zhutianwei/HighLevel/README.md

# HighLevel
Process available data to produce a vehicle speed and direction
