zhutianwei/HighLevel/HighLevel_Test/README.txt

Area for testing High level to not affect the main system.
Added Serial.Print() statements and hard coded areas for 
testing and isolating parts of the code in the lab
while not having to deal with the problems of not getting
new GPS readings or no SD card with your specific board etc.

Synced with Main 6-13-19
