zhutianwei/HighLevel/Function-Test Sketches (All test sketches here)/SerialCmd.html

Serial commands

There are two formats for the keyword. Those starting with '$' are comma separated values, followed by a checksum. Commands starting with a character other than '$' have arguments grouped by braces into keywords and values. The former may be used with instruments; the latter is the format used for interprocessor communication.

DRIVE

GameBots serial command format allows replacement by the USARSim simulator. Since USARsim is no longer available, the Gamebots format has been modified:

1. D {s ComandedSpeed} {a ComandedSteerAngle}

Where:

{s ComandedSpeed} ComandedSpeed is an intege giving the speed for the rear wheel in centimeters per second.

The value is the speed, in centimeters / second.

{a ComandedSteerAngle} ComandedSteerAngle is an integer that specifies the steer angle

of Elcano’s front wheels. The value is the absolute steer angle, in degrees.

Example: D {s 259} {a -3}

SENSOR

A similar format will be used for sensed information from C6.

2. S {s ActualSpeed}

ActualSpeed gives the speed for the rear wheel.

The value is the speed, in centimeters per second.

Other sensors are:

3. S {a Deg}

Steering angle of the front wheels, in degrees times.

0 degrees is straight ahead, small positive numbers are degrees to the right.

Negative numbers (mod 360) are degrees to the left.

4. S {p EPosMeters,NPosMeters} {b Deg}

// Best estimate of vehicle position, fused from all sensors.

The East and North positions are relative to the origin.

Bearing tells which way the vehicle is pointing.

OTHER

5. G {n Num} {p EPosMeters,NPosMeters} {b Deg}

5a. G {n Num} {p EPosMeters,NPosMeters} {b Deg} {r Probability}

6. X {n Num} {p EPosMeters,NPosMeters} {b Deg} {s SegSpeed}

Goal gives the positions of the cones, which may be updated from visual information. The next goal is always {Num 1} If a bearing is present, it is the desired direction of approach to the goal.

The localization processor passes messages 4, SENSOR and 5, GOAL to the vision processor. The vision processor then computes the expected position of the cone in the image. After processing the image, it will compute an updated cone position, including the probability that a cone is present in the image. It passes message 5a back to the vision processor.

Segment 1 is the next desired position from the present position. These are followed by Segments 2, 3, 4, 5. Farther segments would not be transmitted. The speed on a segment is the recommended speed, taking account of conditions and turning radius.

GPS

NMEA Output sentences $GPxxx. These include $GPRMC, $GPVTG. $GPGGA, $GPGSA and $GPGSV. See http://www.adafruit.com/datasheets/GlobalTop-FGPMMOPA6H-Datasheet-V0A.pdf

Communication to the GPS receiver uses NMEA PMTK packets such as $PMTK220, $PMTK314 and $PMTK605. See http://www.adafruit.com/datasheets/PMTK_A08.pdf

Maps

Format is similar to NMEA output. '*xx' means the character '*' followed by a checksum.

$MAPLS,N*xx

Requests processor N to list the names of all maps.

$MAPTX,N,count,num,name*xx

Processor N transmits the name of map num of count. Count is the number of maps on the processor.

$MAPSL,N,name*xx

Request processor N to send contents of map 'name'.

$MAPLN,N,count,num,data*xx

Processor N sends line num of count for the requested map. 'Data' consists of

node,latitude,longitude,PositionEast,PositionNorth,Link1,Link2,Link3,Link4,Dist1,Dist2,Dist3,Dist4

Where

node is the name or number of the point.

latitude and longitude are in decimal degrees.

Positions are in meters

Links are other nodes that are directly linked to this node. If there are more than four, use two different names for the present node, but separate them by zero distance. If there are fewer than four, that field is blank.

Dist are distances in meters along the road to a node.

Example data:

8,47.760342,-122.189784,71.903,154.917,2,7,15,,268.441,142.961,269.358,

15,47.757929,-122.189467,95.599,-113.397,8,16,18,,269.358,26.369,182.216,

13,47.621921,-122.348628,170.313,69.008,14,,,,18.578,,,,

The maps themselves are internal to C4 and its SD card. They do not have to be transmitted. C4 needs to have additional information about the route. From this information, it will produce the next portion of the drive path, which will be transmitted to C3.

The map for the SD card must contain information about the links between nodes. Each link will have the following information:

$LNKLST,startNode,endNode,numberOfSegments,segmentIndex1,...,segmentIndexN

$LNKSEG,index,nextIndex,PositionEast,PositionNorth,bearing,width,speed
