zhutianwei/HighLevel/Function-Test Sketches (All test sketches here)/SelfDrive-master (previous high level code)/ReadMe.txt

The selfDrive-master is high level code wrote by previous capstone team. The algo still working but they use Elcano serial instead of CAN bus.
