zhutianwei/HighLevel/Function-Test Sketches (All test sketches here)/SelfDrive-master (previous high level code)/High_Level_System/README

This is the most updated High level System test with C6, C4 and C3 together. 
Make sure to also include the High-level-libraries when running this code.

Note: C4 is commented out because the A star algorithm still need further integration and testing.
