zhutianwei/HighLevel/Function-Test Sketches (All test sketches here)/SelfDrive-master (previous high level code)/High_Level_Test/README

This is the most updated version of the High level code with a mostly tested and working version of C6 and C3. 
Make sure to also include the High-level-libraries when running this code.
