zhutianwei/HighLevel/Electronics/High-Level PCB v3.0.brd

## EAGLE design Electronics/High-Level PCB v3.0.brd (2019-08-13)

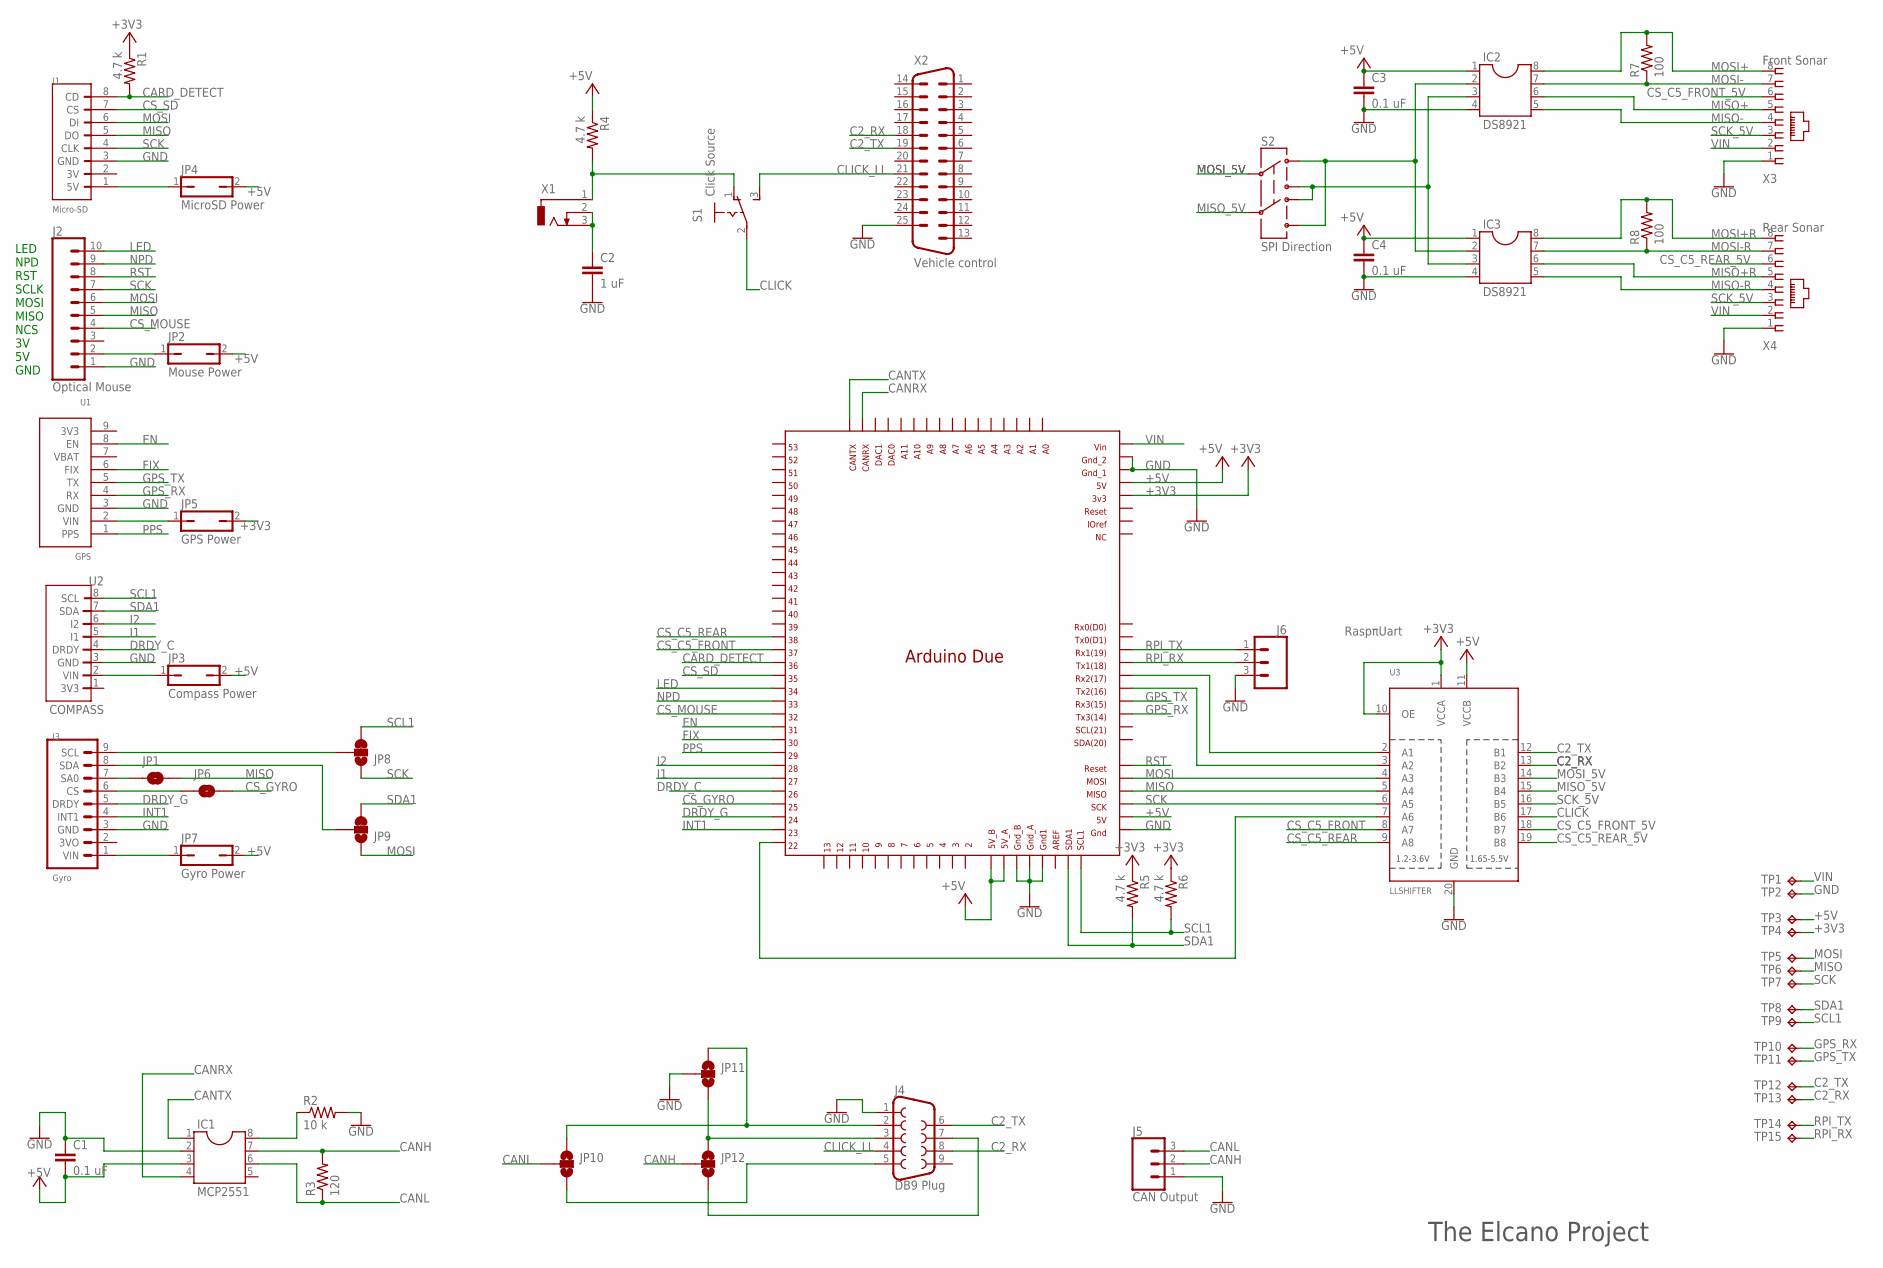
[picture p18: schematic High-Level PCB v3.0.sch]

Parts:
C1, C3, C4: 0.1 uF; C2.5-5
C2: 1 uF; C2.5-5
IC1: MCP2551; DIL08
IC2, IC3: DS8921; DIL08
J1: Micro-SD; ELSDCARD
J2: Optical Mouse; 1X10
J3: Gyro; ELGYRO
J4: DB9 Plug; DB9_MALE
J5: CAN Output; SCREWTERMINAL-5MM-3
J6: RaspπUart; 1X03
JP1, JP6: JUMPER-SMT_2_NO_SILK; SMT-JUMPER_2_NO_SILK
JP2: Mouse Power; JP1
JP3: Compass Power; JP1
JP4: MicroSD Power; JP1
JP5: GPS Power; JP1
JP7: Gyro Power; JP1
JP8, JP9: JUMPER-SMT_3_1-NC_TRACE_SILK; SMT-JUMPER_3_1-NC_TRACE_SILK
JP10, JP11, JP12: JUMPER-SMT_3_NO_SILK; SMT-JUMPER_3_NO_SILK
MCU1: DUE(NORMAL)
R1, R4, R5, R6: 4.7 k; 0204/7
R2: 10 k; 0204/7
R3: 120; 0204/7
R7, R8: 100; 0204/7
S1: Click Source; SP_ELSWITCH
S2: SPI Direction; DPDT
TP1, TP2, TP3, TP4, TP5, TP6, TP7, TP8, TP9, TP10, TP11, TP12, TP13, TP14, TP15: TPPAD1-17; P1-17
U1: GPS; ELGPS
U2: COMPASS; ELCOMPASS
U3: LLSHIFTER; ELSHIFTER
X1: 2.5MMJACK
X2: Vehicle control; M25H
X3: Front Sonar; RJ45-NO-SHIELD
X4: Rear Sonar; RJ45-NO-SHIELD

Connections:
+3V3: JP5.2, MCU1.3V3, R1.1, R5.1, R6.1, TP4.TP, U3.1 (VCCA), U3.10 (OE)
+5V: C1.2, C3.1, C4.1, IC1.3, IC2.1, IC3.1, JP2.2, JP3.2, JP4.2, JP7.2, MCU1.5V, MCU1.5V_A, MCU1.5V_B, MCU1.GND_ICSP, R4.1, TP3.TP, U3.11 (VCCB)
C2_RX: J4.8, TP13.TP, U3.13 (B2), X2.18
C2_TX: J4.6, TP12.TP, U3.12 (B1), X2.19
CANH: IC1.7, J5.2, JP12.2, R3.2
CANL: IC1.6, J5.3, JP10.2, R3.1
CANRX: IC1.4, MCU1.CANRX
CANTX: IC1.1, MCU1.CANTX
CARD_DETECT: J1.8 (CD), MCU1.36, R1.2
CLICK: S1.2, U3.17 (B6)
CLICK_LL: J4.4, S1.3 (S), X2.21
CS_C5_FRONT: MCU1.37, U3.8 (A7)
CS_C5_FRONT_5V: U3.18 (B7), X3.6
CS_C5_REAR: MCU1.38, U3.9 (A8)
CS_C5_REAR_5V: U3.19 (B8), X4.6
CS_GYRO: JP6.2, MCU1.25
CS_MOUSE: J2.4, MCU1.32
CS_SD: J1.7 (CS), MCU1.35
DRDY_C: MCU1.26, U2.4 (DRDY)
DRDY_G: J3.5 (DRDY), MCU1.24
EN: MCU1.31, U1.8 (EN)
FIX: MCU1.30, U1.6 (FIX)
GND: C1.1, C2.2, C3.2, C4.2, IC1.2, IC2.4, IC3.4, J1.3 (GND), J2.1, J3.3 (GND), J4.1, J5.1, J6.3, JP11.2, MCU1.5V_ICSP, MCU1.GND1, MCU1.GND_1, MCU1.GND_2, MCU1.GND_A, MCU1.GND_B, R2.2, TP2.TP, U1.3 (GND), U2.3 (GND), U3.20 (GND), X2.25, X3.1, X4.1
GPS_RX: MCU1.TX3, TP10.TP, U1.4 (RX)
GPS_TX: MCU1.RX3, TP11.TP, U1.5 (TX)
I1: MCU1.27, U2.5 (I1)
I2: MCU1.28, U2.6 (I2)
INT1: J3.4 (INT1), MCU1.23
LED: J2.10, MCU1.34
MISO: J1.5 (DO), J2.5, JP1.2, MCU1.MISO_ICSP, TP6.TP, U3.5 (A4)
MISO+: IC2.6, X3.5
MISO+R: IC3.6, X4.5
MISO-: IC2.5, X3.4
MISO-R: IC3.5, X4.4
MISO_5V: S2.5, U3.15 (B4)
MOSI: J1.6 (DI), J2.6, JP9.1, MCU1.MOSI_ICSP, TP5.TP, U3.4 (A3)
MOSI+: IC2.8, R7.2, X3.8
MOSI+R: IC3.8, R8.2, X4.8
MOSI-: IC2.7, R7.1, X3.7
MOSI-R: IC3.7, R8.1, X4.7
MOSI_5V: S2.2, U3.14 (B3)
unnamed: C2.1, X1.2, X1.3
unnamed: IC2.2, IC3.2, S2.1, S2.6
unnamed: IC2.3, IC3.3, S2.3, S2.4
unnamed: MCU1.TX2, U3.3 (A2)
unnamed: MCU1.RX2, U3.2 (A1)
unnamed: R4.2, S1.1 (O), X1.1
unnamed: JP3.1, U2.2 (VIN)
unnamed: J3.1 (VIN), JP7.1
unnamed: J1.1 (5V), JP4.1
unnamed: J4.3, JP11.3, JP12.1
unnamed: MCU1.22, U3.7 (A6)
unnamed: J2.2, JP2.1
unnamed: JP5.1, U1.2 (VIN)
unnamed: J4.5, JP10.3
unnamed: J4.7, JP12.3
unnamed: IC1.8, R2.1
unnamed: J4.2, JP10.1, JP11.1
unnamed: J3.6 (CS), JP6.1
unnamed: J3.7 (SA0), JP1.1
unnamed: J3.8 (SDA), JP9.2
unnamed: J3.9 (SCL), JP8.2
NPD: J2.9, MCU1.33
PPS: MCU1.29, U1.1 (PPS)
RPI_RX: J6.2 (1), MCU1.TX1, TP15.TP
RPI_TX: J6.1 (2), MCU1.RX1, TP14.TP
RST: J2.8, MCU1.RESET_ICSP
SCK: J1.4 (CLK), J2.7, JP8.1, MCU1.SCK_ICSP, TP7.TP, U3.6 (A5)
SCK_5V: U3.16 (B5), X3.3, X4.3
SCL1: JP8.3, MCU1.SCL1, R6.2, TP9.TP, U2.8 (SCL)
SDA1: JP9.3, MCU1.SDA1, R5.2, TP8.TP, U2.7 (SDA)
VIN: MCU1.VIN, TP1.TP, X3.2, X4.2

Notes on the sheet:
LED NPD RST SCLK MOSI MISO NCS 3V 5V GND
The Elcano Project

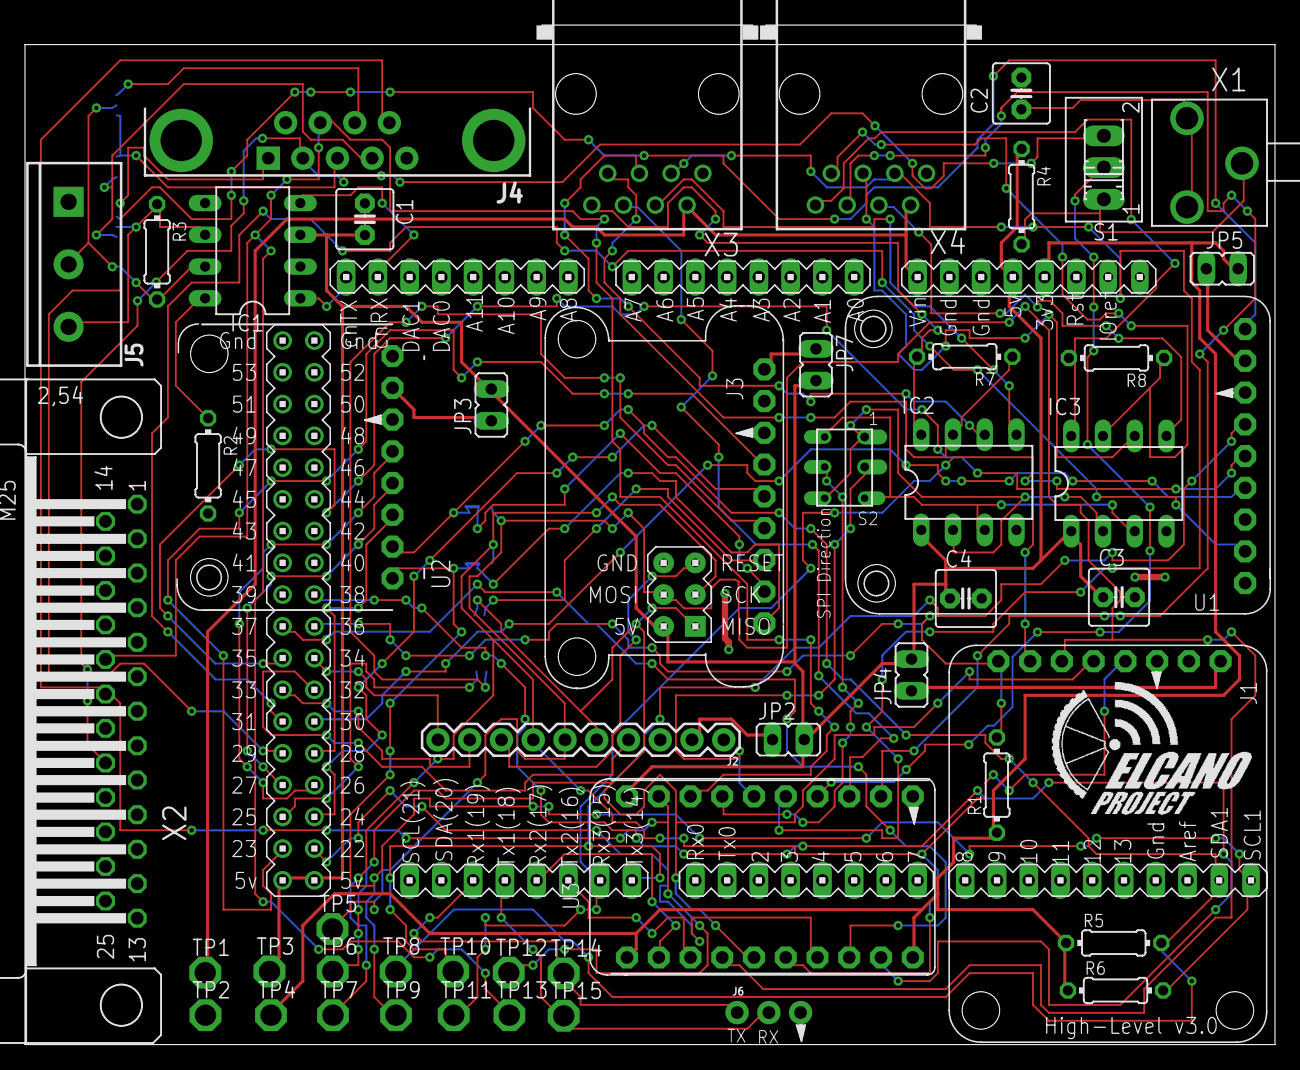
[picture p19: board High-Level PCB v3.0.brd from above]

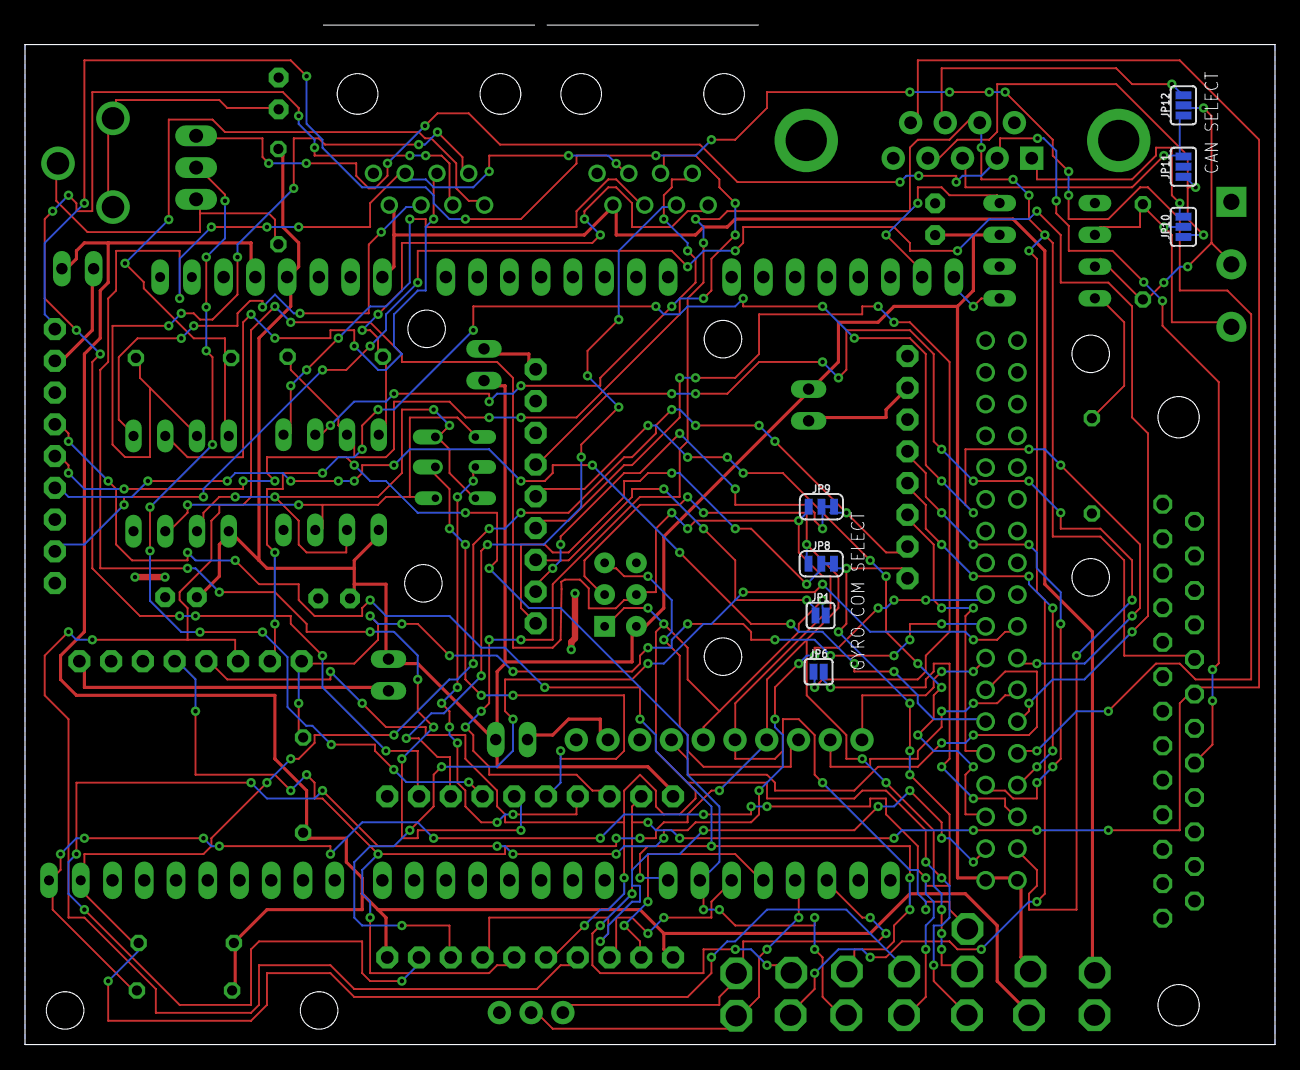
[picture p20: board High-Level PCB v3.0.brd from below]

Board: 2 copper layers, 100.0 x 81.6 mm, 58 parts (7 on the bottom side), 72 nets.
