zhutianwei/HighLevel/High_Level/Localization.cpp

#include "Localization.h"
#define mySerial Serial3

Adafruit_GPS GPS(&mySerial);
//Adafruit_L3GD20 gyro; GYRO still not working
//#ifdef USE_I2C

  // The default constructor uses I2C
  Adafruit_L3GD20 gyro;
//#else
 // To use SPI, you have to define the pins
 // #define GYRO_CS 4 // labeled CS
 // #define GYRO_DO 5 // labeled SA0
 // #define GYRO_DI 6  // labeled SDA
 // #define GYRO_CLK 7 // labeled SCL
 // Adafruit_L3GD20 gyro(GYRO_CS, GYRO_DO, GYRO_DI, GYRO_CLK);
//#endif

namespace elcano {
/******************************************************************************************************
 * constructor for Localization
 *  activates the GPS, Compass, Gyroscope and finds initial positoin
 *****************************************************************************************************/
Localization::Localization(Origin &org, Waypoint &estimated_position, Waypoint &oldPos) {
  //originSt = new elcano::Origin(47.760850, -122.190044); //center of UW soccer field
  //setting up the GPS rate
  setup_GPS();

  //Enable auto-gain
  mag.enableAutoRange(true);
  accel.enableAutoRange(true);
  
  if(!accel.begin())
  {
    /* There was a problem detecting the ADXL345 ... check your connections */
    if(DEBUG) Serial.println("Ooops, no accelerometer detected ... Check your wiring!");
  }
  if (!mag.begin()) {
    if(DEBUG)  Serial.println("no magnetometer detected ... Check your wiring!");
  }
  mag.begin();
  accel.begin();
  
  initial_position(org, estimated_position,oldPos); //getting your initial position from GPS comment out if no GPS available
  //set starting speed to 0 
  newPos.speed_mmPs = 0;
  
  // Try to initialise and warn if we couldn't detect the chip
  if (!gyro.begin(gyro.L3DS20_RANGE_250DPS))
  //if (!gyro.begin(gyro.L3DS20_RANGE_500DPS))
  //if (!gyro.begin(gyro.L3DS20_RANGE_2000DPS))
  {
    if(DEBUG) Serial.println("Oops ... unable to initialize the gyro. Check your wiring!");
  }
}

/********************************************************************************************************
 * setup_GPS()
 * initializes the GPSRATE chooses option of GGA
 *******************************************************************************************************/
void Localization::setup_GPS() {
  //Serial 3 (mySerial) is used for GPS
  mySerial.begin(GPSRATE);
  // Serial3.begin(GPSRATE);
  GPS.begin(GPSRATE);

  // uncomment this line to turn on RMC (recommended minimum) and GGA (fix data) including altitude
  //GPS.sendCommand(PMTK_SET_NMEA_OUTPUT_RMCGGA);
  // uncomment this line to turn on only the "minimum recommended" data
  GPS.sendCommand(PMTK_SET_NMEA_OUTPUT_RMCONLY);
  // For parsing data, we don't suggest using anything but either RMC only or RMC+GGA since
  // the parser doesn't care about other sentences at this time

  // Set the update rate
  GPS.sendCommand(PMTK_SET_NMEA_UPDATE_1HZ);   // 5 Hz update rate
  // For the parsing code to work nicely and have time to sort thru the data, and
  // print it out we don't suggest using anything higher than 1 Hz

  // Request updates on antenna status, comment out to keep quiet
  GPS.sendCommand(PGCMD_ANTENNA);
}

/********************************************************************************************************
 * AcquireGPS()
 * Searches for a GPS signal, has an option for hardcoding the GPS
 * when being tested in the lab without changing signal in the beginning lines
 * param: gps_position to record gps position if found
 * return: true if gps is found
 *******************************************************************************************************/
bool Localization::AcquireGPS(Waypoint &gps_position) {
  if(DEBUG) Serial.println("Acquire GPS");
  float latitude, longitude;
  
  char c;
  //read atleast 25 characters every loop speed up update time for GPS
  for (int i = 0; i < 25; i++) {
    c = GPS.read();
  }
  
  // if a sentence is received, we can check the checksum, parse it...
  if (GPS.newNMEAreceived()) {
  //  Serial.println("newNMEArecieved");
    // a tricky thing here is if we print the NMEA sentence, or data
    // we end up not listening and catching other sentences!
    // so be very wary if using OUTPUT_ALLDATA and trytng to print out data
    //Serial.println(GPS.lastNMEA());   // this also sets the newNMEAreceived() flag to false

    if (!GPS.parse(GPS.lastNMEA()))   // this also sets the newNMEAreceived() flag to false
      return false;  // we can fail to parse a sentence in which case we should just wait for another

    if (GPS.fix) {
      gps_position.latitude = GPS.latitudeDegrees;
      if(DEBUG)  Serial.println("Latitude: " + String(gps_position.latitude, 6));
      gps_position.longitude = GPS.longitudeDegrees;
      if(DEBUG)  Serial.println("Longitude: " + String(gps_position.longitude, 6));
      return true;
    }
    return false;
  }
  return false;
}

/*******************************************************************************************************
 * Local_communication_with_LowLevel()
 * Receive actual speed and actual turn angle from the C2_Lowlevel 
 * board via CAN BUS message to help calculate where the trike's estimated position in
 ******************************************************************************************************/
void Localization::Local_communication_with_LowLevel() {
  CAN.watchForRange(Actual_CANID, LowStatus_CANID);  //filter for low level communication
  
  while (CAN.available() > 0) { // check if CAN message available
    CAN.read(incoming);
    
    if(DEBUG2) {
      Serial.println("Get data from (low level) ID: " + String(incoming.id, HEX));
      Serial.print("Low: " + String((int)incoming.data.low, DEC));
      Serial.println(", High: " + String((int)incoming.data.high, DEC));
    }

    if(incoming.id == Actual_CANID) {
      extractSpeed = incoming.data.low;
      
      if  (extractSpeed >= 0) {
        newPos.speed_mmPs = extractSpeed; //upadte acutal speed from C2
      }
      
      else
        if(DEBUG)  Serial.println("Got a negative speed from C2");
    }
    
  else 
    if(DEBUG)  Serial.println("Did not receive actual speed, angle from C2");
  }
}

/*******************************************************************************************************
 * getHeading()
 * checks the compass to get the heading in degrees
 ******************************************************************************************************/
long Localization::getHeading() {
  //Get a new sensor event from the magnetometer
  sensors_event_t event;
  mag.getEvent(&event);      
  
  //Calculate the current heading (angle of the vector y,x)
  //Normalize the heading
  float heading = (atan2(event.magnetic.y, event.magnetic.x) * 180) / PIf;
  if(DEBUG)  Serial.println("acquired heading: " + String(heading));
  if (heading < 0)  {
    heading = 360 + heading;
  }
  if(DEBUG3) Serial.println("Heading is: " + String(heading));
  return heading;
}

/*******************************************************************************************************
 * getGyroRoll()
 * uses gyroscope to get Gyroscope roll
 ******************************************************************************************************/
 double Localization::getGyroRoll(){
  gyro.read();
  if(DEBUG) Serial.println("Gyroscope Roll X: " + String(gyro.data.x));
  return gyro.data.x;
 }
 /*******************************************************************************************************
 * getGyroPitch()
 * uses gyroscope to get GyroPitch
 ******************************************************************************************************/
 double Localization::getGyroPitch(){
  gyro.read();
  if(DEBUG) Serial.println("Gyroscope Pitch Y: " + String(gyro.data.y)); 
  return gyro.data.y;
}
 /*******************************************************************************************************
 * getGyroYaw()
 * uses gyroscope to get GyroYaw
 ******************************************************************************************************/
 double Localization::getGyroYaw(){
  gyro.read();
  if(DEBUG) Serial.println("Gyroscope Yaw Z: " + String(gyro.data.z)); 
  return gyro.data.z;
  }
  
 /*******************************************************************************************************
 * getAccelX()
 * uses acceleromenter to get Acceleration in X axis
 ******************************************************************************************************/
 double Localization::getAccelX() {
  //Get a new sensor event from the magnetometer
  sensors_event_t event;
  accel.getEvent(&event);      
  
  double accelerationX = event.acceleration.x;
  /* Display the results (acceleration is measured in m/s^2) */
  if(DEBUG3)Serial.println("Acceleration X: " + String(event.acceleration.x) + "  m/s^2 ");
  
  return accelerationX;
}

 /*******************************************************************************************************
 * getAccelY()
 * uses acceleromenter to get Acceleration in Y axis
 ******************************************************************************************************/
 double Localization::getAccelY() {
  //Get a new sensor event from the magnetometer
  sensors_event_t event;
  accel.getEvent(&event);      
  
  double accelerationY = event.acceleration.y;
  /* Display the results (acceleration is measured in m/s^2) */
  if(DEBUG3)Serial.println("Acceleration Y: " + String(event.acceleration.y) +  "  m/s^2 ");

  return accelerationY;
}

/*******************************************************************************************************
 * getAccelZ()
 * uses acceleromenter to get Acceleration in Z axis
 ******************************************************************************************************/
 double Localization::getAccelZ() {
  //Get a new sensor event from the magnetometer
  sensors_event_t event;
  accel.getEvent(&event);      
  
  double accelerationZ = event.acceleration.z;
  /* Display the results (acceleration is measured in m/s^2) */
  if(DEBUG3)Serial.println("Acceleration Z: " + String(event.acceleration.z) +  "  m/s^2 ");
  
  return accelerationZ;
}

 /*******************************************************************************************************
 * findPosition()
 * currently uses the estimated position dead reckoning and GPS if a new GPS
 * reading was acquired to calculate a new estimated position
 * later should use accelerometer with the Kalman filter for better results
 * sets the estimPos vectors values to the newly calculated position
 ******************************************************************************************************/
void Localization::findPosition(Waypoint &estimPos, bool got_GPS, Waypoint &oldPos) {
  newPos.time_ms = millis(); //mark current time
  
  //get heading coordinates from the compass
  newPos.bearing_deg = getHeading();
  estimPos.bearing_deg = newPos.bearing_deg; //used to find first path in Pilot.cpp
  if(DEBUG)  Serial.println("loop6 newPos.bearing_deg = " + String(newPos.bearing_deg));

  //for use in Kalman filter - may want to move this somewhere else
  double accelX = getAccelX();
  double accelY = getAccelY();
  double accelZ = getAccelZ();
  double gyroRoll = getGyroRoll();
  double gyroPitch = getGyroPitch();
  double gyroYaw = getGyroYaw();
  
  if (got_GPS) { 
    if(DEBUG)  Serial.println("got gps and deadreckoning");
    
    //to get an esitimation position average between the GPS and Dead Rekoning
    //estimPos is updated to the current position inside this method
    
    FindFuzzyCrossPointXY(GPS_reading, newPos, estimPos);
    
    //calculating the E and N vector by constantly updating everything you move 
    oldPos.vectors(&estimPos);
  }
  else { 
    if(DEBUG)  Serial.println("Only got dead reckoning");
    // calculate position using Dead Reckoning
    ComputePositionWithDR(oldPos, newPos);

    //calculating the E and N unit vector
    oldPos.vectors(&newPos);

    //update new current positon
    estimPos.east_mm = newPos.east_mm;
    estimPos.north_mm = newPos.north_mm;
  }
  
  //update E and N vector of current position 
  estimPos.Evector_x1000 = oldPos.Evector_x1000;
  estimPos.Nvector_x1000 = oldPos.Nvector_x1000;
  if(DEBUG3) Serial.println("--- North: " + String(estimPos.north_mm) + ", East: " + String(estimPos.east_mm) + "\n");
  
  //update old position to current 
  oldPos = estimPos;
}


/*******************************************************************************************************
 * initial_position()
 * Get your first initial position form the GPS
 ******************************************************************************************************/
void Localization::initial_position(Origin &ogn, Waypoint &estimPos, Waypoint &old_pos) {
  
  bool GPS_available = AcquireGPS(estimPos);

  //This makes an infinite loop when the GPS is not available, comment out or hard code for testing 4-8-19 Mel
  while (!GPS_available) {
    GPS_available = AcquireGPS(estimPos); 
  }
  
  if(DEBUG)  Serial.println("Acquired GPS position");
  estimPos.time_ms = millis();
  estimPos.Compute_EandN_Vectors(getHeading()); //get position E and N vector
  //Assign Origin GPS position?? not map origin??
  //ogn.
  if(DEBUG)  Serial.println("Computed Vectors in initial position");

  //moving to planner where compute estim_pos due to origin not being set yet. may need to move old_pos too
  //oldPos to keep track of previous position for DR
  old_pos = estimPos;
}

/******************************************************************************************************
 * update loop for Localization
 *  gets a new GPS signal, Deadreckoning data from the Lowlevel
 *  and uses this data to estimate the current position of the trike
 *****************************************************************************************************/
void Localization::update(Origin &ogn, Waypoint &estimated_position, Waypoint &oldPos) {
  oldPos.time_ms = millis();
  delay(1);
  
  got_GPS = AcquireGPS(GPS_reading);  //try to get a new GPS position
  int test = 0;
  while(got_GPS == false && test < 5){
    got_GPS = AcquireGPS(GPS_reading);
    test++; 
  }
  
  Local_communication_with_LowLevel(); // Receiving speed data from C2 using CAN Bus
  
  if (got_GPS) {
    GPS_reading.Compute_mm(ogn); // get north and east coordinates from originStl
    if(DEBUG)  Serial.println("Got and computed GPS");
  }
  else {
    if(DEBUG)  Serial.println("Failed to get got_GPS");
  }
  findPosition(estimated_position, got_GPS, oldPos); //determine location based on dead reckoning and GPS
}   

} // namespace elcano
